DVMProject/dvmv24/hw/v1/dvm-v24.pdf

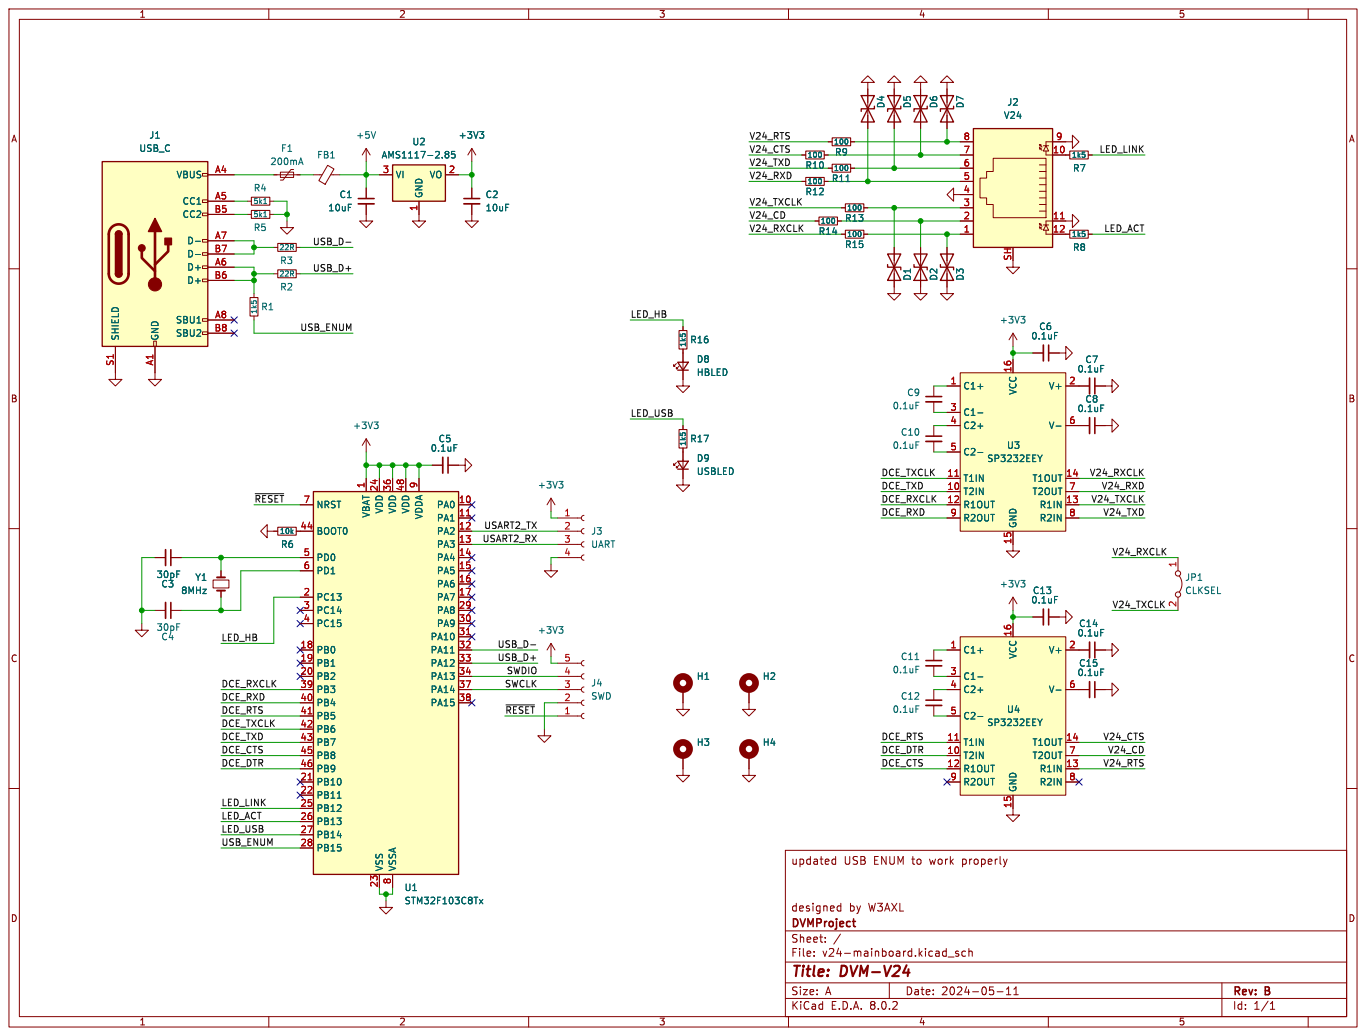
[picture p6: page 1]

File: v24-mainboard.kicad_sch Sheet: / DVMProject
