DVMProject/dvmv24/fw/Core/Src/main.c

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
/* Includes ------------------------------------------------------------------*/
#include "main.h"
#include "dma.h"
#include "iwdg.h"
#include "tim.h"
#include "usart.h"
#ifdef DVM_V24_V1
#include "usb_device.h"
#endif
#include "gpio.h"

/* USER CODE BEGIN Includes */
#include "leds.h"
#include "log.h"
#include "log.h"
#include "serial.h"
#include "sync.h"
#include "util.h"
#include "vcp.h"
#include "hdlc.h"
/* USER CODE END Includes */


/* USER CODE BEGIN PV */
unsigned long rxValidFrames = 0;
unsigned long rxTotalFrames = 0;
unsigned long txTotalFrames = 0;

// LED timers
unsigned long lastHb = 0;
unsigned long lastSync = 0;

/* USER CODE END PV */

void SystemClock_Config(void);
/* USER CODE BEGIN 0 */

#ifdef DVM_V24_V1 // HB LED is only on DVM-V24 V1 boards
void hbLED()
{
    if (HAL_GetTick() - lastHb > 1000)
    {
        LED_HB(1);
        lastHb = HAL_GetTick();
    }
    else if (HAL_GetTick() - lastHb > 100)
    {
        LED_HB(0);
    }
}
#endif

void linkLED()
{
    if (SyncRxState == SYNCED)
    {
        LED_LINK(1);
    }
    else
    {
        LED_LINK(0);
    }
}

#ifndef DVM_V24_V1

/**
 * @brief Jump to the STM32 USART1 system bootloader
 *
 * Taken from the dvmfirmware-hs function of the same name
 */
void jumpToBootloader()
{
    // De-init RCC
    HAL_RCC_DeInit();

    // De-init TIM2
    //HAL_TIM_Base_DeInit(&htim2);

    // De-init USART1 & 2 (also de-inits DMA)
    HAL_UART_MspDeInit(&huart1);
    HAL_UART_MspDeInit(&huart2);

    // Disable Systick timer
    SysTick->CTRL = 0;
    SysTick->LOAD = 0;
    SysTick->VAL = 0;

    // Clear Interrupt Enable Register & Interrupt Pending Register
    for (uint8_t i = 0; i < sizeof(NVIC->ICER) / sizeof(NVIC->ICER[0]); i++)
    {
        NVIC->ICER[i] = 0xFFFFFFFF;
        NVIC->ICPR[i] = 0xFFFFFFFF;
    }

    volatile uint32_t addr = 0x1FFFF000;

    // Update the NVIC's vector
    SCB->VTOR = addr;

    void (*SysMemBootJump)(void);
    SysMemBootJump = (void (*)(void))(*((uint32_t *)(addr + 4)));
    __ASM volatile("MSR msp, %0" : : "r"(*(uint32_t *)addr) : "sp"); // __set_MSP
    SysMemBootJump();
}

#endif

/* USER CODE END 0 */

/**
 * @brief  The application entry point.
 * @retval int
 */
int main(void)
{

    /* USER CODE BEGIN 1 */
#ifndef DVM_V24_V1
    // Check if we need to jump straight to the system bootloader (borrowed from dvmfirmware-hs main())
    if ((STM32_CNF_PAGE[STM32_CNF_PAGE_24] != 0xFFFFFFFFU) && (STM32_CNF_PAGE[STM32_CNF_PAGE_24] != 0x00U))
    {
        // Check if the bootload mode flag is set
        uint8_t bootloadMode = (STM32_CNF_PAGE[STM32_CNF_PAGE_24] >> 8) & 0xFFU;
        if ((bootloadMode & 0x20U) == 0x20U)
        {
            // Setup the erase struct
            static FLASH_EraseInitTypeDef EraseInitStruct;
            // Storage for errors from the erase command
            uint32_t sectorError;
            // Unlock Flash
            HAL_FLASH_Unlock();
            // Clear the config page
            EraseInitStruct.TypeErase = FLASH_TYPEERASE_PAGES;
            EraseInitStruct.PageAddress = STM32_CNF_PAGE_ADDR;
            EraseInitStruct.NbPages = 1;
            if (HAL_FLASHEx_Erase(&EraseInitStruct, &sectorError) != HAL_OK)
            {
                HAL_FLASH_Lock();
                return HAL_FLASH_GetError();
            }
            // Jump
            jumpToBootloader();
        }
    }
#endif
    /* USER CODE END 1 */

    /* MCU Configuration--------------------------------------------------------*/

    /* Reset of all peripherals, Initializes the Flash interface and the Systick. */
    HAL_Init();

    /* Configure the system clock */
    SystemClock_Config();

    /* Initialize all configured peripherals */
    MX_GPIO_Init();
    MX_DMA_Init();
    MX_USART2_UART_Init();
    MX_TIM2_Init();
#ifdef DVM_V24_V1
    MX_USB_DEVICE_Init();
#else
    MX_USART1_UART_Init();
#endif
    MX_IWDG_Init();
    /* USER CODE BEGIN 2 */
    // Init stuff
    log_set_uart(&huart2);
    // SerialClear(&huart2);
    SerialStartup(&huart2);

// Enumerate the VCP
// log_info("Enumerating USB VCP");
#ifdef DVM_V24_V1
    VCPEnumerate();
#endif

    // Start sync serial handler
    log_info("Starting synchronous serial handler");
    SyncStartup(&htim2);

    // Done!
    log_info("Startup complete");
    VCPWriteDebug1("Startup complete");
    SyncReset();

// Warn that watchdog is disbaled
#ifdef DISABLE_WATCHDOG
    log_warn("System watchdog timers disbaled!");
#endif

    /* USER CODE END 2 */

    /* Infinite loop */
    /* USER CODE BEGIN WHILE */
    while (1)
    {
        // Processing callbacks
        RxMessageCallback();
        HdlcCallback();
        VCPRxCallback();
        VCPTxCallback();
        SerialCallback(&huart2);
// LED callbacks
#ifdef DVM_V24_V1
        hbLED();
#endif
        linkLED();
// Refresh the IWDG watchdog
#ifndef DISABLE_WATCHDOG
        HAL_IWDG_Refresh(&hiwdg);
#endif
        /* USER CODE END WHILE */

        /* USER CODE BEGIN 3 */
    }
    /* USER CODE END 3 */
}

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
/* USER CODE BEGIN 4 */

// Override for calling sync callback
void HAL_TIM_PeriodElapsedCallback(TIM_HandleTypeDef *htim)
{
    SyncTimerCallback();
}

/**
 * @brief Reset the STM32
 *
 */
void ResetMCU()
{
    //log_warn("MCU is resetting!");
    //HAL_Delay(250);
    LED_ACT(0);
    LED_LINK(0);
#ifdef DVM_V24_V1
    LED_HB(0);
    LED_USB(0);
#else
    LED_USB_RX(0);
    LED_USB_TX(0);
#endif
    HAL_Delay(250);
    HAL_NVIC_SystemReset();
}

/* USER CODE END 4 */
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
