DVMProject/dvmv24/fw/Core/Inc/main.h

#define PROG_NAME "DVM-V24"
#define LED_HB_Pin GPIO_PIN_13
#define LED_HB_GPIO_Port GPIOC
#define LED_LINK_Pin GPIO_PIN_12
#define LED_LINK_GPIO_Port GPIOB
#define LED_ACT_Pin GPIO_PIN_13
#define LED_ACT_GPIO_Port GPIOB
#define LED_USB_Pin GPIO_PIN_14
#define LED_USB_GPIO_Port GPIOB
#define USB_ENUM_Pin GPIO_PIN_15
#define USB_ENUM_GPIO_Port GPIOB
#define DCE_RXCLK_Pin GPIO_PIN_3
#define DCE_RXCLK_GPIO_Port GPIOB
#define DCE_RXD_Pin GPIO_PIN_4
#define DCE_RXD_GPIO_Port GPIOB
#define DCE_RTS_Pin GPIO_PIN_5
#define DCE_RTS_GPIO_Port GPIOB
#define DCE_TXCLK_Pin GPIO_PIN_6
#define DCE_TXCLK_GPIO_Port GPIOB
#define DCE_TXD_Pin GPIO_PIN_7
#define DCE_TXD_GPIO_Port GPIOB
#define DCE_CTS_Pin GPIO_PIN_8
#define DCE_CTS_GPIO_Port GPIOB
#define DCE_DTR_Pin GPIO_PIN_9
#define DCE_DTR_GPIO_Port GPIOB
