DVMProject/dvmv24/(commit log)

2024-03-16 fixed USB enum and added debug logging
    [config.h, log.c, main.c, vcp.c, vcp.h]
2024-03-18 undid the extra buffer nonsense because it didn't help and shouldn't be needed
    [fifo.c, sync.c, sync.h, vcp.c, vcp.h]
2024-05-11 updated schematic to rev B
2024-06-06 added small tweaks to error handling to prevent log spam
    [config.h, serial.c, sync.c, sync.h, vcp.c]
2024-06-09 small fix for some GCCs not liking the switch cases, added additional debug print
    [vcp.c]
2024-06-09 don't clear the terminal on reset (was making debug hard)
    [main.c]
2024-07-17 added STM32 UDID reporting
2024-07-26 updated buffer lengths for VCP and V24, temporary fix
    [config.h, hdlc.c, sync.c, sync.h, vcp.h]
2024-08-12 modified buffer sizes, fixed possible infinite loop with fifo errors, added hardfault handler
    [fault.c, fault.h, fifo.c, main.c, serial.c, serial.h, vcp.h]
2024-08-21 extra logging for hdlc failures
    [sync.c]
2024-08-22 made variables changed in interrupts volatile
2024-10-09 updated periodic print defines
2024-10-10 update STM32CubeMX project to match (mostly)
2024-10-15 mostly working v2 firmware, now with flashing over UART
2024-10-15 disabled extra debug prints and updated NAK reason for unhandled commands
2024-10-20 brought back the RX timeout and made it work, the USART is still being weird but this temp fix should work for now
    [vcp.c, vcp.h]
2024-10-20 increased RX timeout slightly, added additional log prints on startup
2024-12-15 schematic and bom updates for v2
2024-12-15 bumped fw revision and disabled periodic status print
